wipfli/hardware/README.md

# hardware
Hardware design files for the ballometer
