wipfli/hardware/pcb/ballometer/ballometer.kicad_pcb

## KiCad design pcb/ballometer/ballometer.kicad_pcb (2020-09-22)

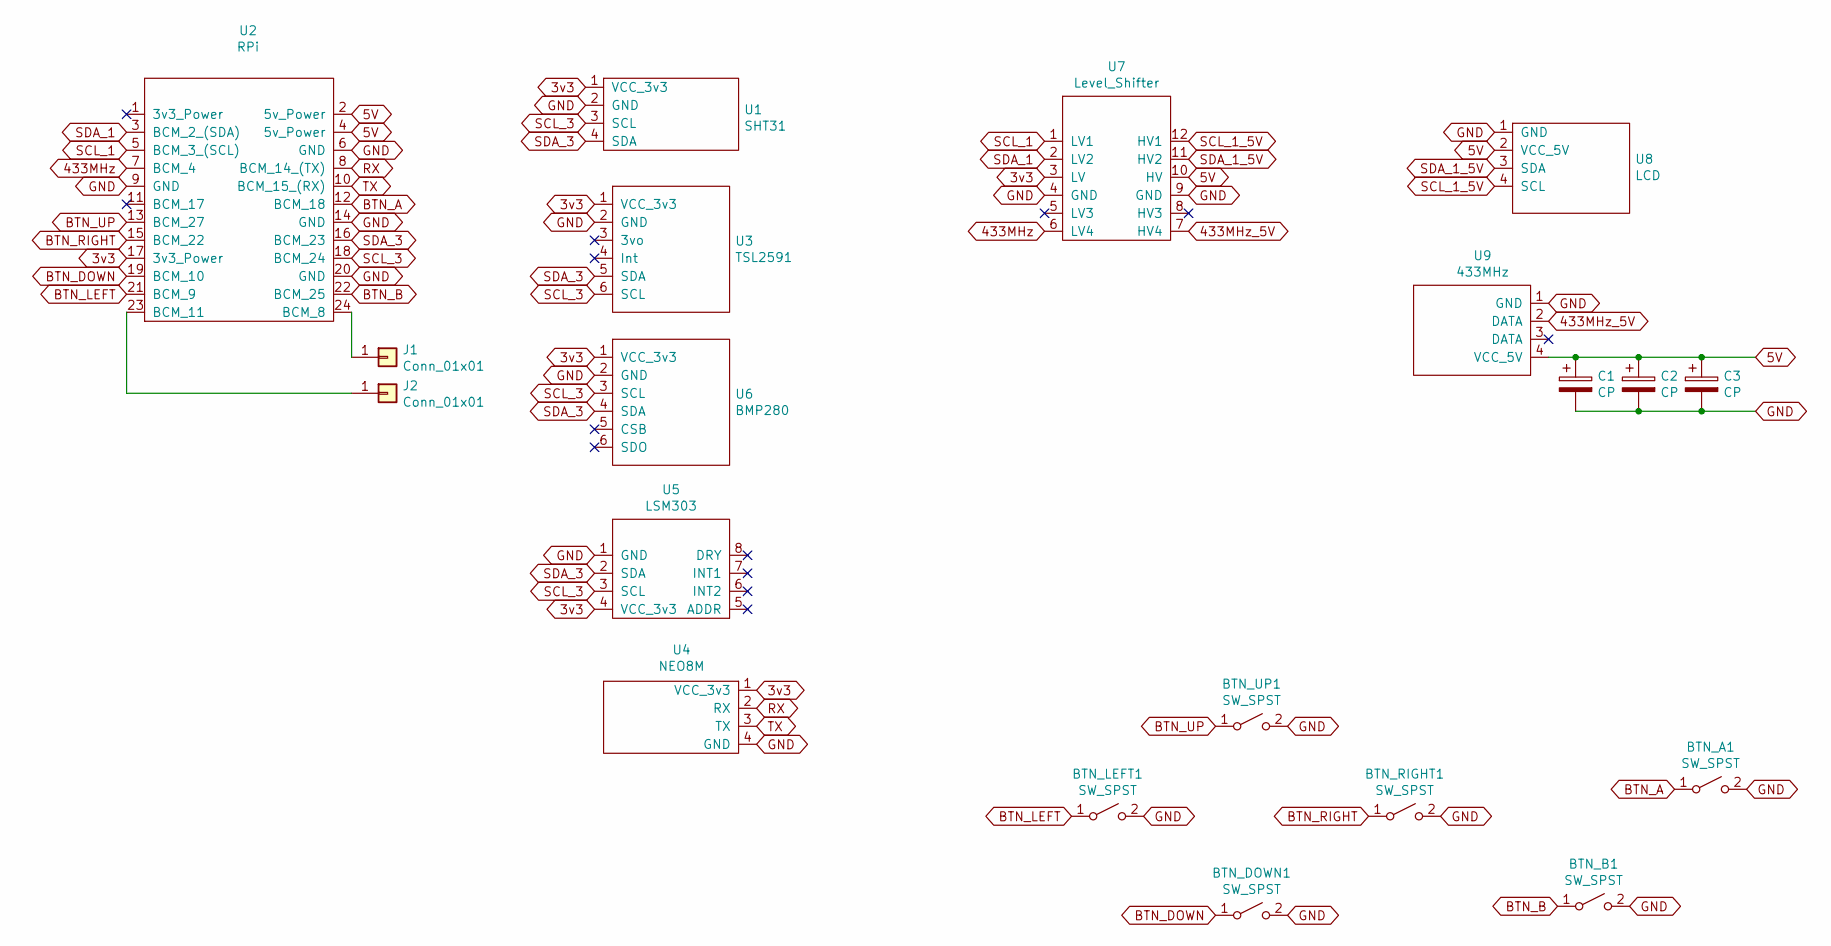
[picture p1: schematic ballometer.sch]

Parts:
BTN_A1: SW_SPST; SW_PUSH_6mm_H4.3mm
BTN_B1: SW_SPST; SW_PUSH_6mm_H4.3mm
BTN_DOWN1: SW_SPST; SW_PUSH_6mm_H4.3mm
BTN_LEFT1: SW_SPST; SW_PUSH_6mm_H4.3mm
BTN_RIGHT1: SW_SPST; SW_PUSH_6mm_H4.3mm
BTN_UP1: SW_SPST; SW_PUSH_6mm_H4.3mm
C1: CP; CP_Radial_D10.0mm_P5.00mm
C2, C3: CP; PinHeader_1x02_P2.54mm_Vertical
J1, J2: Conn_01x01; PinHeader_1x01_P2.54mm_Vertical
U1: SHT31
U2: RPi; PinHeader_2x12_P2.54mm_Vertical
U3: TSL2591; TLS2591
U4: NEO8M
U5: LSM303
U6: BMP280
U7: Level_Shifter
U8: LCD
U9: 433MHz

Connections:
3v3: U1.1 (VCC_3v3), U2.17 (3v3_Power), U3.1 (VCC_3v3), U4.1 (VCC_3v3), U5.4 (VCC_3v3), U6.1 (VCC_3v3), U7.3 (LV)
5V: C1.1, C2.1, C3.1, U2.2 (5v_Power), U2.4 (5v_Power), U7.10 (HV), U8.2 (VCC_5V), U9.4 (VCC_5V)
433MHz: U2.7 (BCM_4), U7.6 (LV4)
433MHz_5V: U7.7 (HV4), U9.2 (DATA)
BTN_A: BTN_A1.1 (A), U2.12 (BCM_18)
BTN_B: BTN_B1.1 (A), U2.22 (BCM_25)
BTN_DOWN: BTN_DOWN1.1 (A), U2.19 (BCM_10)
BTN_LEFT: BTN_LEFT1.1 (A), U2.21 (BCM_9)
BTN_RIGHT: BTN_RIGHT1.1 (A), U2.15 (BCM_22)
BTN_UP: BTN_UP1.1 (A), U2.13 (BCM_27)
GND: BTN_A1.2 (B), BTN_B1.2 (B), BTN_DOWN1.2 (B), BTN_LEFT1.2 (B), BTN_RIGHT1.2 (B), BTN_UP1.2 (B), C1.2, C2.2, C3.2, U1.2 (GND), U2.6 (GND), U2.9 (GND), U2.14 (GND), U2.20 (GND), U3.2 (GND), U4.4 (GND), U5.1 (GND), U6.2 (GND), U7.4 (GND), U7.9 (GND), U8.1 (GND), U9.1 (GND)
unnamed: J1.1, U2.24 (BCM_8)
unnamed: J2.1, U2.23 (BCM_11)
RX: U2.8 (BCM_14_(TX)), U4.2 (RX)
SCL_1: U2.5 (BCM_3_(SCL)), U7.1 (LV1)
SCL_1_5V: U7.12 (HV1), U8.4 (SCL)
SCL_3: U1.3 (SCL), U2.18 (BCM_24), U3.6 (SCL), U5.3 (SCL), U6.3 (SCL)
SDA_1: U2.3 (BCM_2_(SDA)), U7.2 (LV2)
SDA_1_5V: U7.11 (HV2), U8.3 (SDA)
SDA_3: U1.4 (SDA), U2.16 (BCM_23), U3.5 (SDA), U5.2 (SDA), U6.4 (SDA)
TX: U2.10 (BCM_15_(RX)), U4.3 (TX)

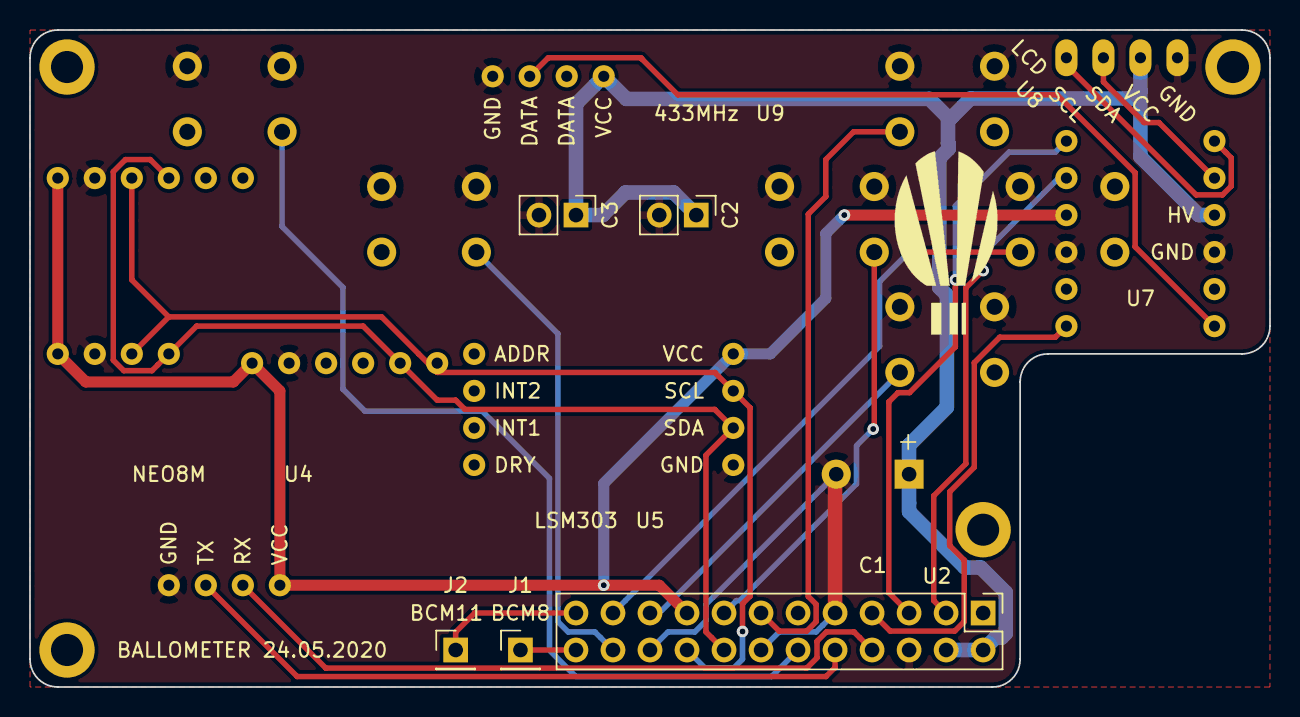
[picture p2: board ballometer.kicad_pcb from above]

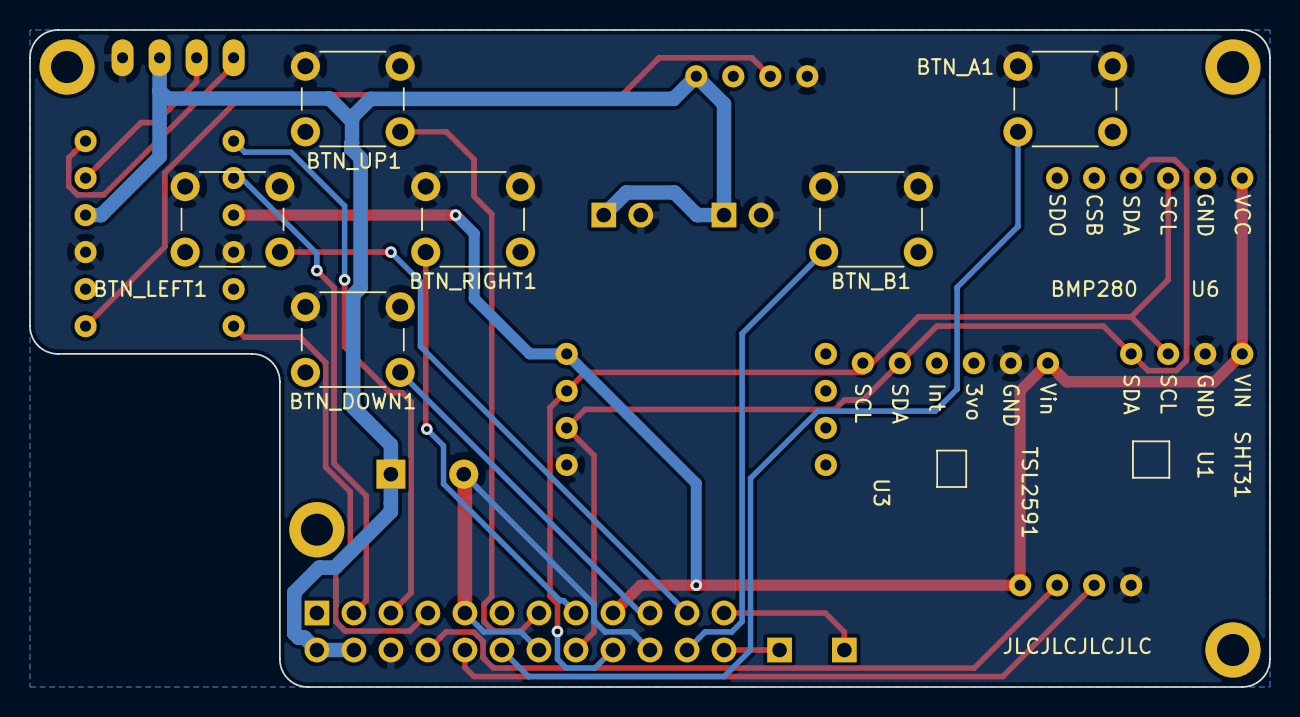
[picture p3: board ballometer.kicad_pcb from below]

Board: 2 copper layers, 85.1 x 45.1 mm, 20 parts (9 on the bottom side), 21 nets.
