wipfli/hardware/(commit log)

2020-09-22 PCB files of the first batch
    [ballometer.kicad_pcb, ballometer.sch]
2020-10-14 Increase wall thicknesss to 3 mm
2021-06-18 Add components.csv
    [components.csv]
2021-06-18 Fill csv with aliexpress / digitec components
    [components.csv]
2021-06-18 Remove components jupyter notebook
    [components.csv]
2021-06-20 Add ribbon cable
    [components.csv]
